Waffelo/HydraFlasher_PCB/HydraFlasher_KiCAD.kicad_pcb

## KiCad design HydraFlasher_KiCAD.kicad_pcb (2026-10-29)

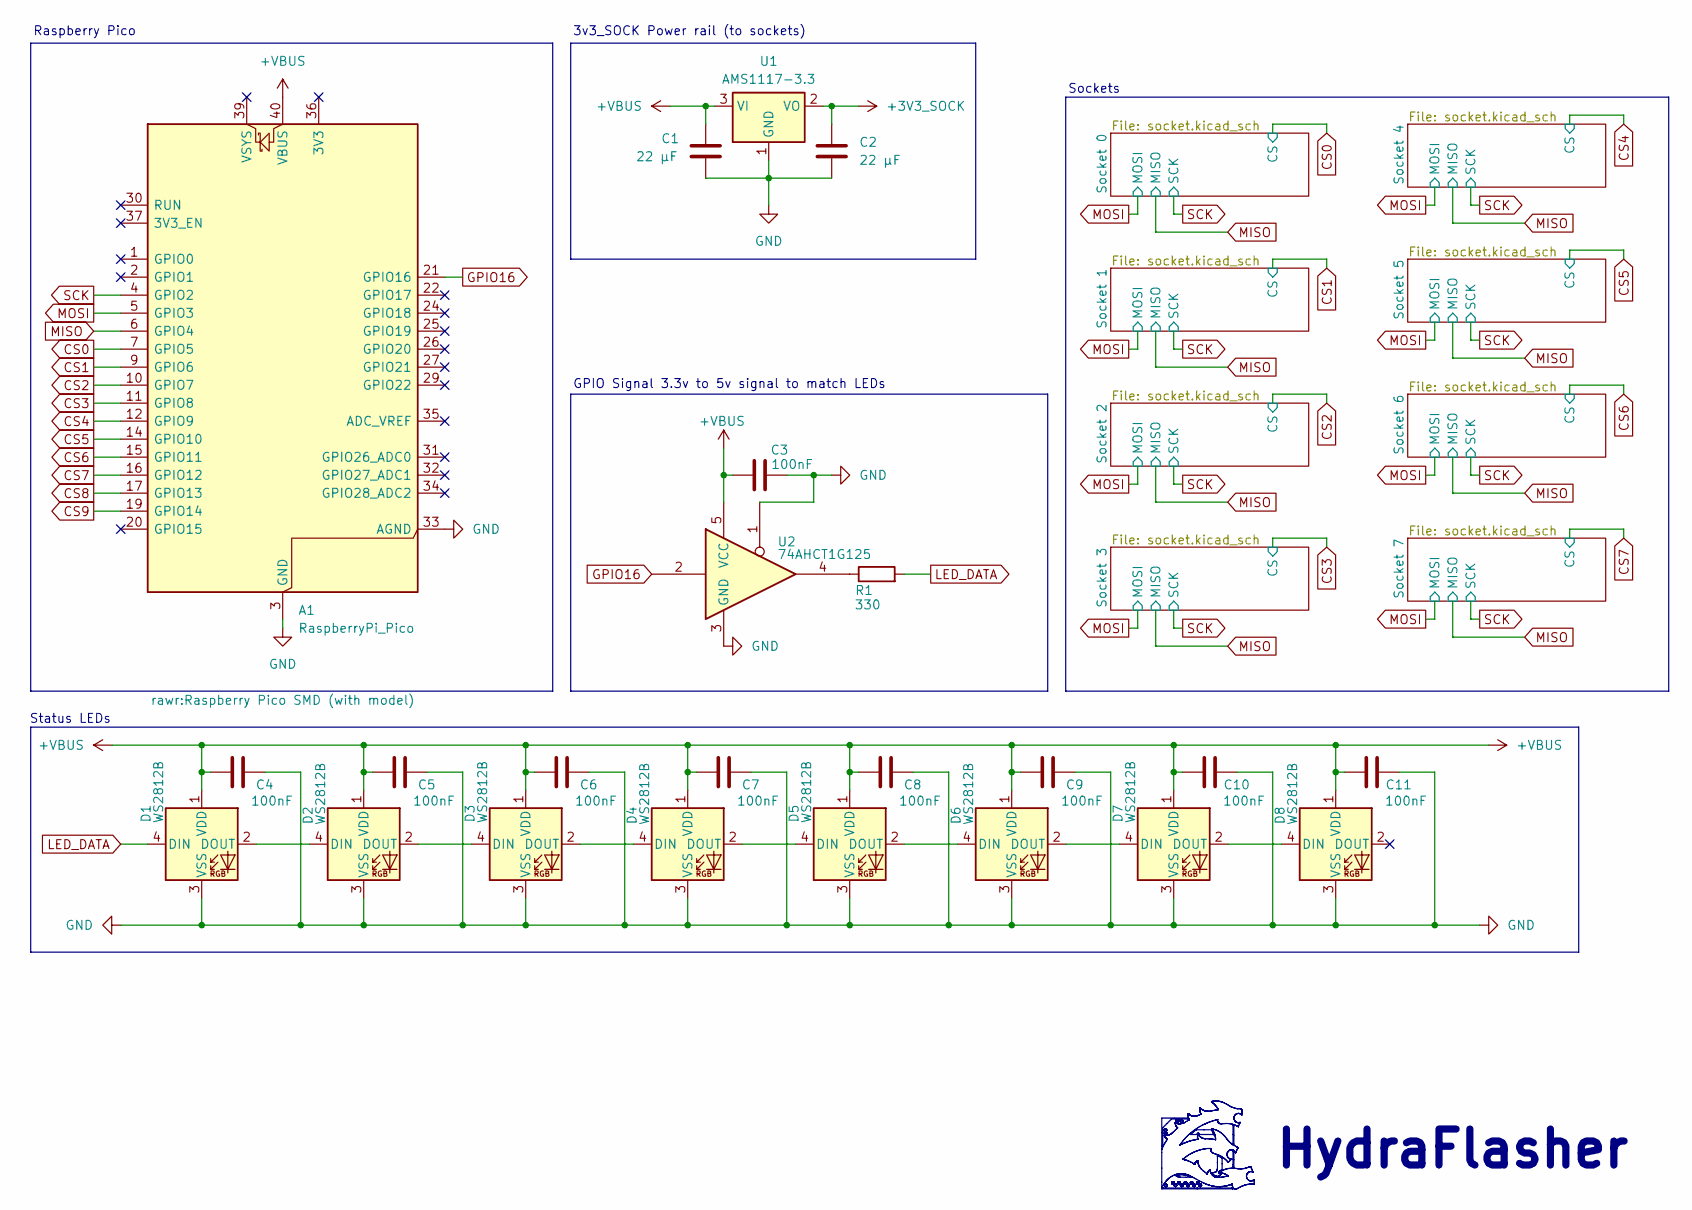
[picture p1: schematic HydraFlasher_KiCAD.kicad_sch, HydraFlasher body (8-sockets)]

Parts:
A1: RaspberryPi_Pico; Raspberry Pico SMD (with model); LCSC C7203002
C1, C2: 22 µF; C_0805_2012Metric_Pad1.18x1.45mm_HandSolder; MPN CC0805MKX5R8BB226; LCSC C784585
C3, C4, C5, C6, C7, C8, C9, C10, C11: 100nF; C_0805_2012Metric; LCSC C49678
D1, D2, D3, D4, D5, D6, D7, D8: WS2812B; LED_WS2812B_PLCC4_5.0x5.0mm_P3.2mm; LCSC C2843785
R1: 330; R_0805_2012Metric_Pad1.20x1.40mm_HandSolder; LCSC C17630
U1: AMS1117-3.3; SOT-223-3_TabPin2; MPN AMS1117-3.3; LCSC C6186
U2: 74AHCT1G125; SOT-23-5_HandSoldering; MPN SN74AHCT1G125DBVR; LCSC C7484

Connections:
+3V3_SOCK: C2.1, U1.2 (VO); also elsewhere on the board
+VBUS: A1.40 (VBUS), C1.1, C3.2, C4.1, C5.1, C6.1, C7.1, C8.1, C9.1, C10.1, C11.1, D1.1 (VDD), D2.1 (VDD), D3.1 (VDD), D4.1 (VDD), D5.1 (VDD), D6.1 (VDD), D7.1 (VDD), D8.1 (VDD), U1.3 (VI), U2.5 (VCC)
CS0: A1.7 (GPIO5); also elsewhere on the board
CS1: A1.9 (GPIO6); also elsewhere on the board
CS2: A1.10 (GPIO7); also elsewhere on the board
CS3: A1.11 (GPIO8); also elsewhere on the board
CS4: A1.12 (GPIO9); also elsewhere on the board
CS5: A1.14 (GPIO10); also elsewhere on the board
CS6: A1.15 (GPIO11); also elsewhere on the board
CS7: A1.16 (GPIO12); also elsewhere on the board
CS8: A1.17 (GPIO13)
CS9: A1.19 (GPIO14)
GND: A1.3 (GND), A1.8 (GND), A1.13 (GND), A1.18 (GND), A1.23 (GND), A1.28 (GND), A1.33 (AGND), A1.38 (GND), C1.2, C2.2, C3.1, C4.2, C5.2, C6.2, C7.2, C8.2, C9.2, C10.2, C11.2, D1.3 (VSS), D2.3 (VSS), D3.3 (VSS), D4.3 (VSS), D5.3 (VSS), D6.3 (VSS), D7.3 (VSS), D8.3 (VSS), U1.1 (GND), U2.1, U2.3 (GND); also elsewhere on the board
GPIO16: A1.21 (GPIO16), U2.2
LED_DATA: D1.4 (DIN), R1.2
MISO: A1.6 (GPIO4); also elsewhere on the board
MOSI: A1.5 (GPIO3); also elsewhere on the board
unnamed: D1.2 (DOUT), D2.4 (DIN)
unnamed: D2.2 (DOUT), D3.4 (DIN)
unnamed: D3.2 (DOUT), D4.4 (DIN)
unnamed: D4.2 (DOUT), D5.4 (DIN)
unnamed: D5.2 (DOUT), D6.4 (DIN)
unnamed: D6.2 (DOUT), D7.4 (DIN)
unnamed: D7.2 (DOUT), D8.4 (DIN)
unnamed: R1.1, U2.4
SCK: A1.4 (GPIO2); also elsewhere on the board

Notes on the sheet:
GPIO Signal 3.3v to 5v signal to match LEDs
Status LEDs
Sockets
HydraFlasher
3v3_SOCK Power rail (to sockets)
Raspberry Pico

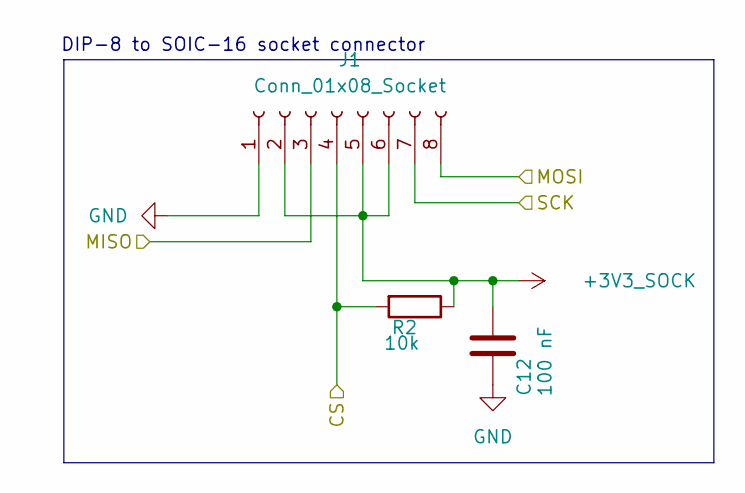
[picture p2: schematic socket.kicad_sch]

Parts:
C12: 100 nF; C_0603_1608Metric; LCSC C1590
J1: Conn_01x08_Socket; DIP8-Hydra
R2: 10k; R_0805_2012Metric_Pad1.20x1.40mm_HandSolder; LCSC C17414

Connections:
+3V3_SOCK: C12.2, J1.2, J1.5, J1.6, R2.1; also elsewhere on the board
CS0: J1.4, R2.2; also elsewhere on the board
GND: C12.1, J1.1; also elsewhere on the board
MISO: J1.3; also elsewhere on the board
MOSI: J1.8; also elsewhere on the board
SCK: J1.7; also elsewhere on the board

Parts of its further copies:
C13, C14, C15, C16, C17, C18, C19: 100 nF; C_0603_1608Metric; LCSC C1590
J2, J3, J4, J5, J6, J7, J8: Conn_01x08_Socket; DIP8-Hydra
R3, R4, R5, R6, R7, R8, R9: 10k; R_0805_2012Metric_Pad1.20x1.40mm_HandSolder; LCSC C17414

Connections of its further copies:
+3V3_SOCK: C13.2, C14.2, C15.2, C16.2, C17.2, C18.2, C19.2, J2.2, J2.5, J2.6, J3.2, J3.5, J3.6, J4.2, J4.5, J4.6, J5.2, J5.5, J5.6, J6.2, J6.5, J6.6, J7.2, J7.5, J7.6, J8.2, J8.5, J8.6, R3.1, R4.1, R5.1, R6.1, R7.1, R8.1, R9.1; also elsewhere on the board
CS1: J2.4, R3.2; also elsewhere on the board
CS2: J3.4, R4.2; also elsewhere on the board
CS3: J4.4, R5.2; also elsewhere on the board
CS4: J5.4, R6.2; also elsewhere on the board
CS5: J6.4, R7.2; also elsewhere on the board
CS6: J7.4, R8.2; also elsewhere on the board
CS7: J8.4, R9.2; also elsewhere on the board
GND: C13.1, C14.1, C15.1, C16.1, C17.1, C18.1, C19.1, J2.1, J3.1, J4.1, J5.1, J6.1, J7.1, J8.1; also elsewhere on the board
MISO: J2.3, J3.3, J4.3, J5.3, J6.3, J7.3, J8.3; also elsewhere on the board
MOSI: J2.8, J3.8, J4.8, J5.8, J6.8, J7.8, J8.8; also elsewhere on the board
SCK: J2.7, J3.7, J4.7, J5.7, J6.7, J7.7, J8.7; also elsewhere on the board

Notes on the sheet:
DIP-8 to SOIC-16 socket connector

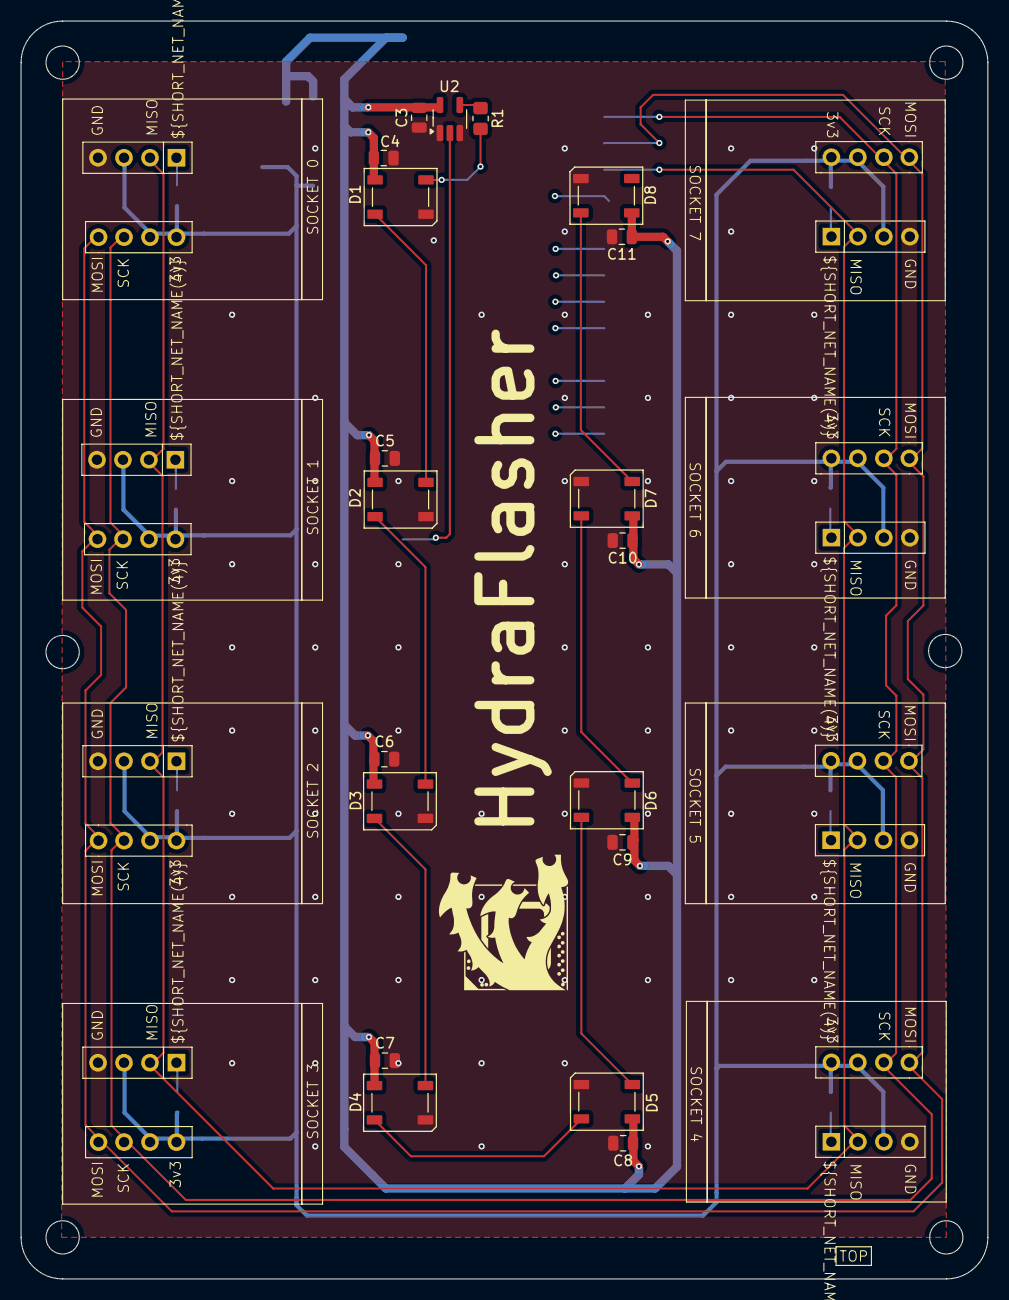
[picture p3: board HydraFlasher_KiCAD.kicad_pcb from above]

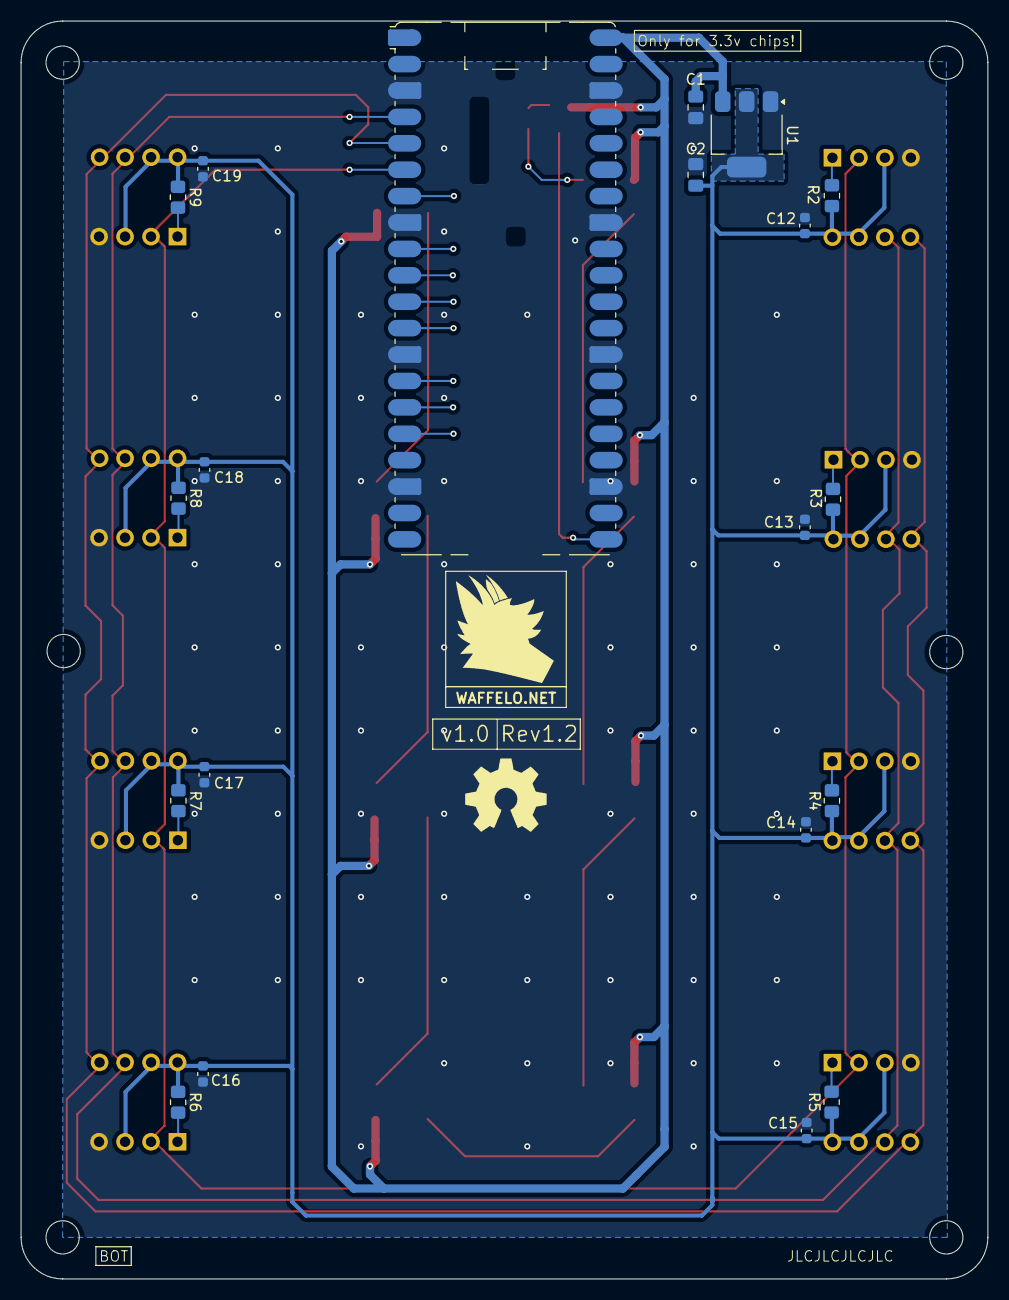
[picture p4: board HydraFlasher_KiCAD.kicad_pcb from below]

Board: 4 copper layers, 93.0 x 121.0 mm, 47 parts (20 on the bottom side), 24 nets.
