Waffelo/HydraFlasher_PCB/(commit log)

2026-10-26 Initial HydraFlasher schematic and PCB
    [HydraFlasher_KiCAD.kicad_pcb, HydraFlasher_KiCAD.kicad_sch, socket.kicad_sch]
2026-10-29 Polishing up
    [BOM-HydraFlasher_KiCAD.csv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]
